WREC-UofA/WRECtangle/Designs/KiCAD Files/readme.md

This is where we'll put KiCAD projects / updates.
