WREC-UofA/WRECtangle/Designs/KiCAD Files/WRECtangleVersions/V4/Wrectangle-V4/WRECtangleMount.It1.SLDPRT

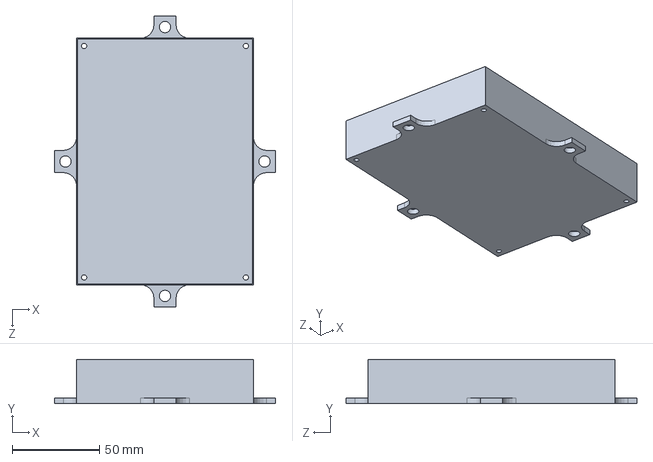
[picture p1: CAD file, 2026-02-07, an earlier design]
Designs/KiCAD Files/WRECtangleVersions/V4/Wrectangle-V4/WRECtangleMount.It1.SLDPRT
126.5 x 25.4 x 166.4 mm
