WREC-UofA/WRECtangle/Designs/KiCAD Files/WRECtangleVersions/V4/24V-RegulatorCircuit.pdf

## WEBENCH ® Design Report

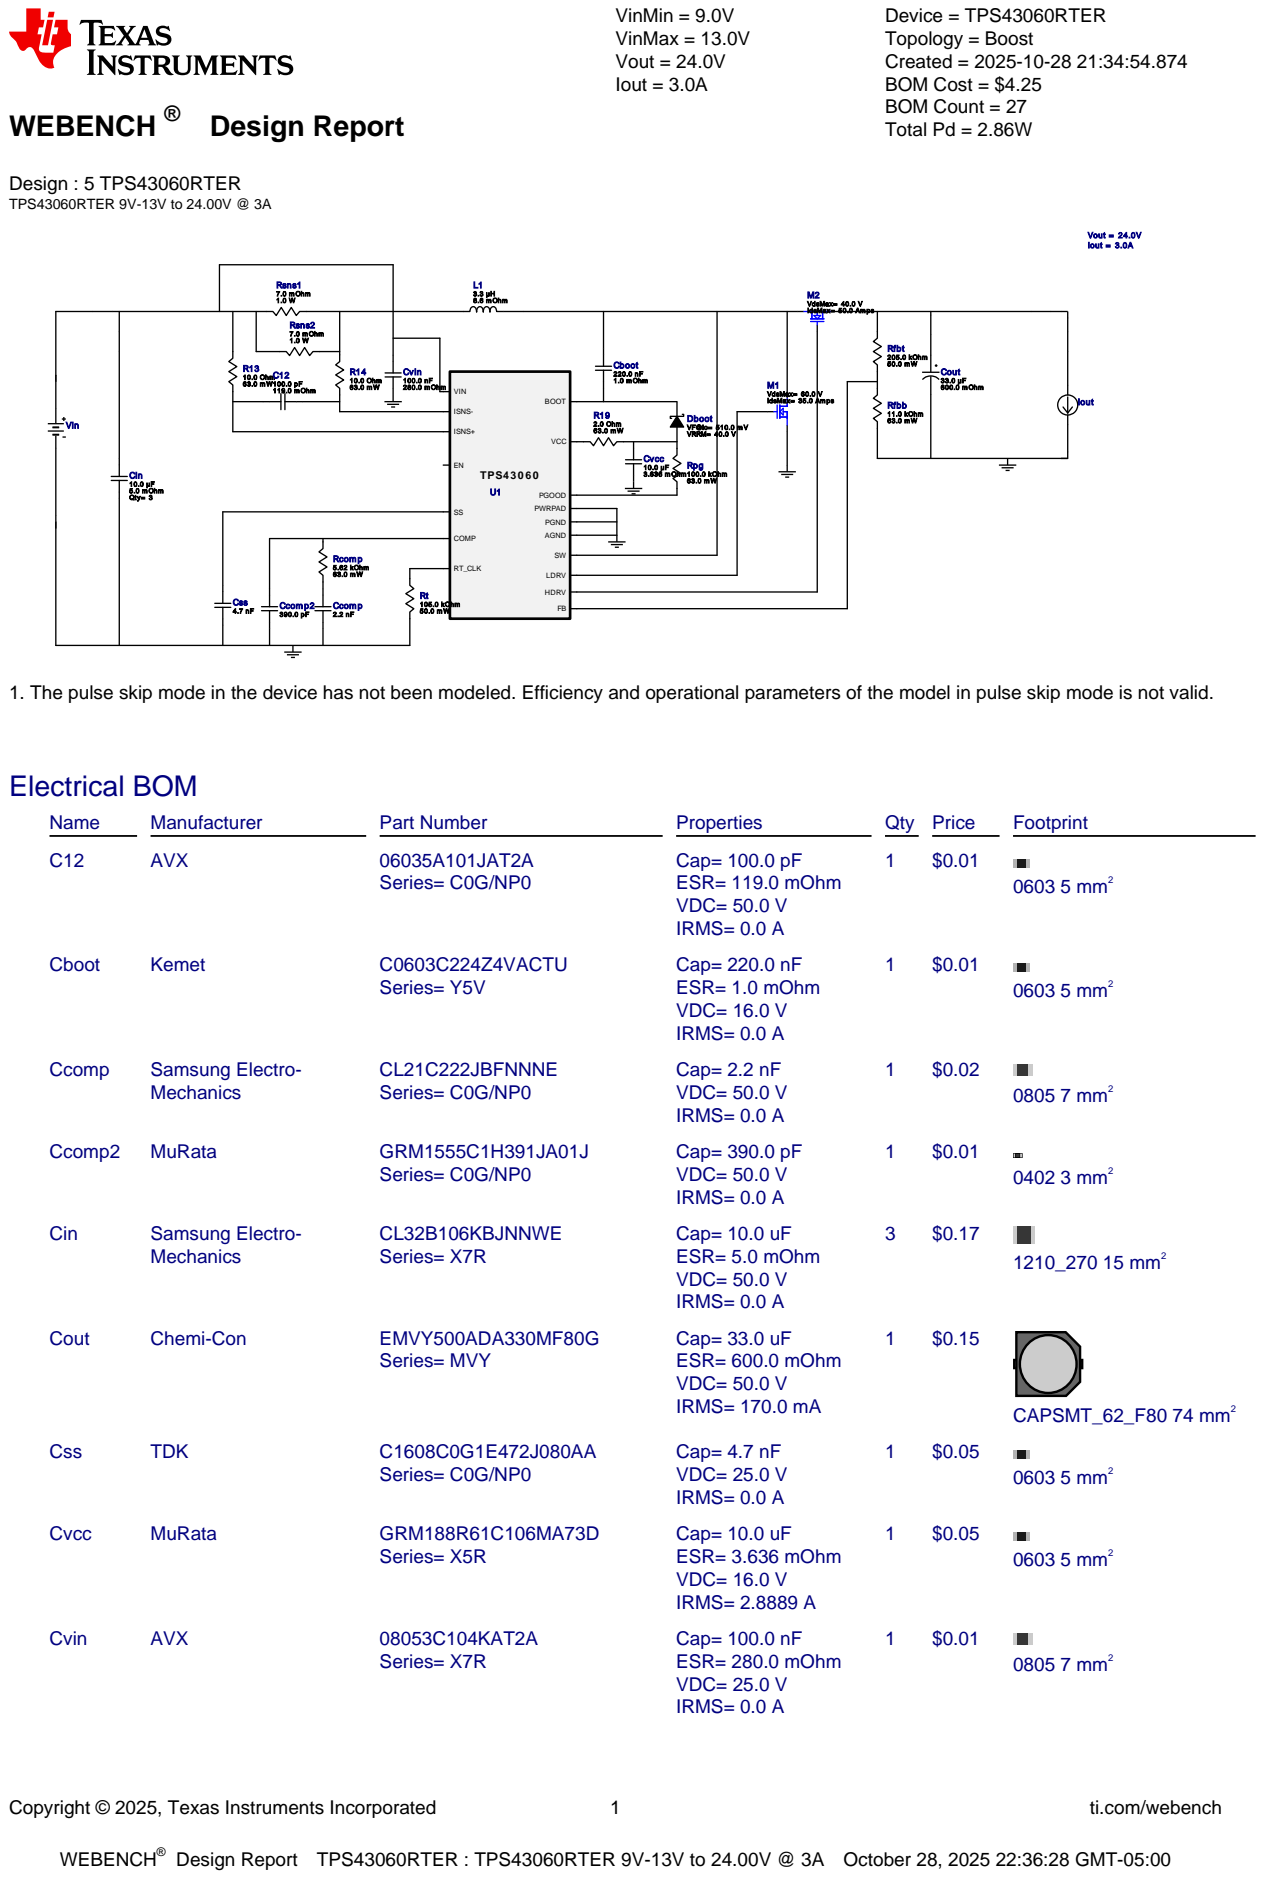
[picture p2: page 1]
Copyright © 2025, Texas Instruments Incorporated; ti.com/webench; WEBENCH®; Design : 5 TPS43060RTER TPS43060RTER 9V-13V to 24.00V @ 3A; VinMin = 9.0V VinMax = 13.0V Vout = 24.0V Iout = 3.0A; Device = TPS43060RTER Topology = Boost Created = 2025-10-28 21:34:54.874 BOM Cost = $4.25 BOM Count = 27 Total Pd = 2.86W; Cout 33.0 µF; 600.0 m Ohm; Cboot 220.0 nF; 1.0 m Ohm; VdsMax= 60.0; IdsMax= 35.0 Am ps; Rfbb; 11.0 kOhm 63.0 m W; R13 10.0 Ohm 63.0 m W; Rpg 100.0 kOhm 63.0 m W; Rfbt 205.0 kOhm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

1. The pulse skip mode in the device has not been modeled. Efficiency and operational parameters of the model in pulse skip mode is not valid.

Design Report TPS43060RTER : TPS43060RTER 9V-13V to 24.00V @ 3A October 28, 2025 22:36:28 GMT-05:00

Design

Copyright © 2025, Texas Instruments Incorporated | 2 | ti.com/webench
Name | Manufacturer | Part Number | Properties | Qty Price | Footprint
Dboot | Comchip Technology | CDBK0540-HF (http://www.comchiptech.com/cms/UserFiles/CDBK0540%2DHF%2DRevB797997.pdf) | VF@Io= 510.0 mV VRRM= 40.0 V
1 | $0.07
| | | | | SOD-123F 12 mm²
L1 | Coilcraft | XAL7070-332MEB (http://www.coilcraft.com/pdfs/xal7070.pdf) | L= 3.3 µH 8.6 mOhm
1 | $1.19

XAL7070 87 mm²
M1 | Texas Instruments | CSD18543Q3A (http://www.ti.com/lit/ds/symlink/csd18543q3a.pdf) | VdsMax= 60.0 V IdsMax= 35.0 Amps | 1 | $0.21

DNH0008A 18 mm²
M2 | Texas Instruments | CSD18514Q5A (http://www.ti.com/lit/ds/symlink/csd18514q5a.pdf) | VdsMax= 40.0 V IdsMax= 50.0 Amps | 1 | $0.22

TRANS_NexFET_Q5A 55
mm²
R13 | Vishay-Dale | CRCW040210R0FKED (http://www.vishay.com/docs/20035/dcrcwe3.pdf) Series= CRCW..e3 | Res= 10.0 Ohm Power= 63.0 mW Tolerance= 1.0% | 1 | $0.01
0402 3 mm²
R14 | Vishay-Dale | CRCW040210R0FKED (http://www.vishay.com/docs/20035/dcrcwe3.pdf) Series= CRCW..e3 | Res= 10.0 Ohm Power= 63.0 mW Tolerance= 1.0% | 1 | $0.01
0402 3 mm²
R19 | Vishay-Dale | CRCW04022R00FKED (http://www.vishay.com/docs/20035/dcrcwe3.pdf) Series= CRCW..e3 | Res= 2.0 Ohm Power= 63.0 mW Tolerance= 1.0% | 1 | $0.01
0402 3 mm²
Rcomp | Vishay-Dale | CRCW04025K62FKED (http://www.vishay.com/docs/20035/dcrcwe3.pdf) Series= CRCW..e3 | Res= 5.62 kOhm Power= 63.0 mW Tolerance= 1.0% | 1 | $0.01
0402 3 mm²
Rfbb | Vishay-Dale | CRCW040211K0FKED (http://www.vishay.com/docs/20035/dcrcwe3.pdf) Series= CRCW..e3 | Res= 11.0 kOhm Power= 63.0 mW Tolerance= 1.0% | 1 | $0.01
0402 3 mm²
Rfbt | Yageo | RC0201FR-07205KL (http://www.yageo.com/exep/pages/download/literatures/PYu%2DR%5FMarking%5F2.pdf) Series= ? | Res= 205.0 kOhm Power= 50.0 mW Tolerance= 1.0% | 1 | $0.01
0201 2 mm²
Rpg | Vishay-Dale | CRCW0402100KFKED (http://www.vishay.com/docs/20035/dcrcwe3.pdf) Series= CRCW..e3 | Res= 100.0 kOhm Power= 63.0 mW Tolerance= 1.0% | 1 | $0.01
0402 3 mm²
Rsns1 | Susumu Co Ltd | PRL1632-R007-F-T1 (http://www.susumu%2Dusa.com/pdf/PRL%5FRL%5FData%5Fsheet.pdf) Series= PRL1632 | Res= 7.0 mOhm Power= 1.0 W Tolerance= 1.0% | 1 | $0.20

0612 11 mm²

Rsns2 | Susumu Co Ltd | PRL1632-R007-F-T1 (http://www.susumu%2Dusa.com/pdf/PRL%5FRL%5FData%5Fsheet.pdf) Series= PRL1632 | Res= 7.0 mOhm Power= 1.0 W Tolerance= 1.0% | 1 | $0.20

0612 11 mm²

Rt | Yageo | RC0201FR-07105KL (http://www.yageo.com/exep/pages/download/literatures/PYu%2DR%5FMarking%5F2.pdf) Series= ? | Res= 105.0 kOhm Power= 50.0 mW Tolerance= 1.0% | 1 | $0.01
0201 2 mm²
U1 | Texas Instruments | TPS43060RTER (http://www.ti.com/product/TPS43060) | Switcher | 1 | $1.09

S-PVQFN-N16 17 mm²

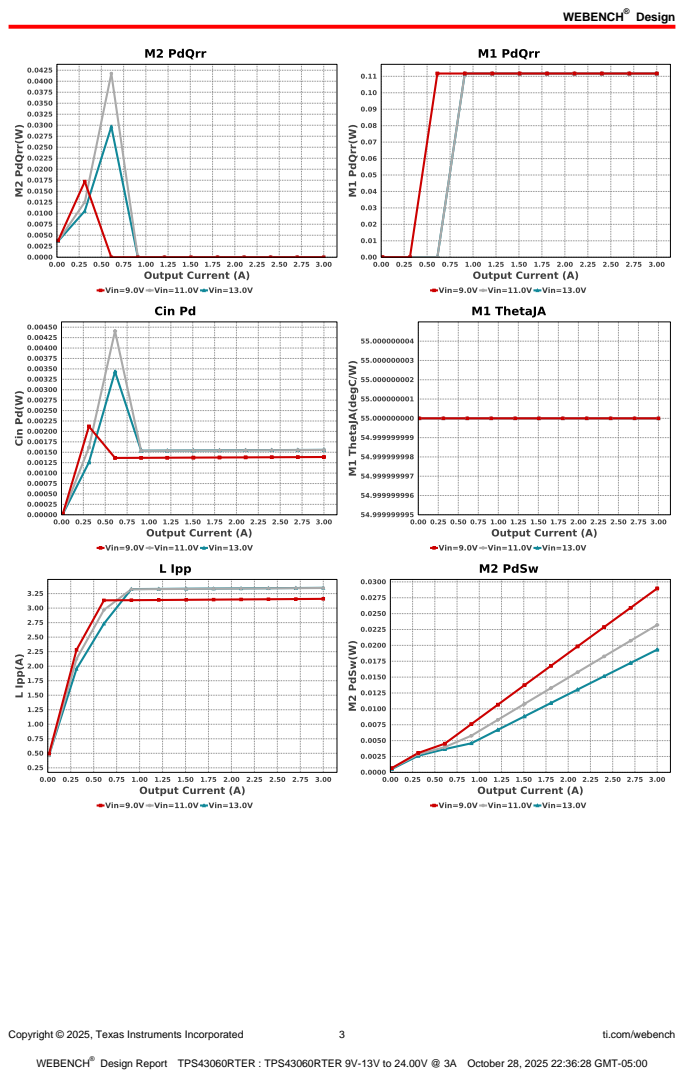
[picture p3: page 3]
Copyright © 2025, Texas Instruments Incorporated; ti.com/webench

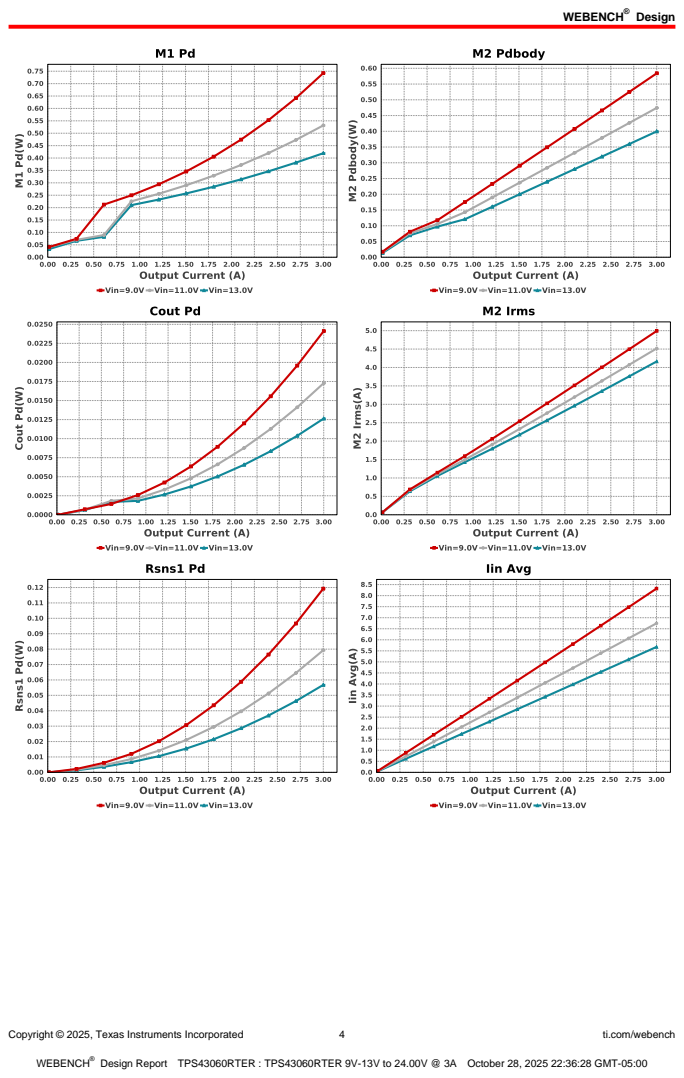
[picture p4: page 4]
Copyright © 2025, Texas Instruments Incorporated; ti.com/webench

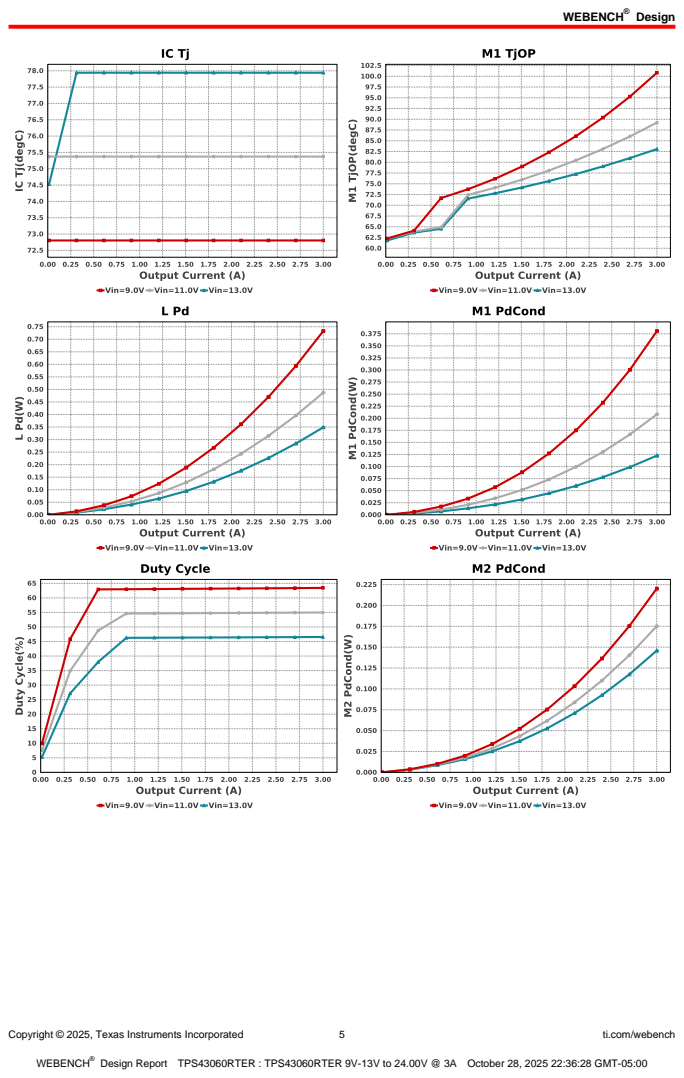
[picture p5: page 5]
Copyright © 2025, Texas Instruments Incorporated; ti.com/webench

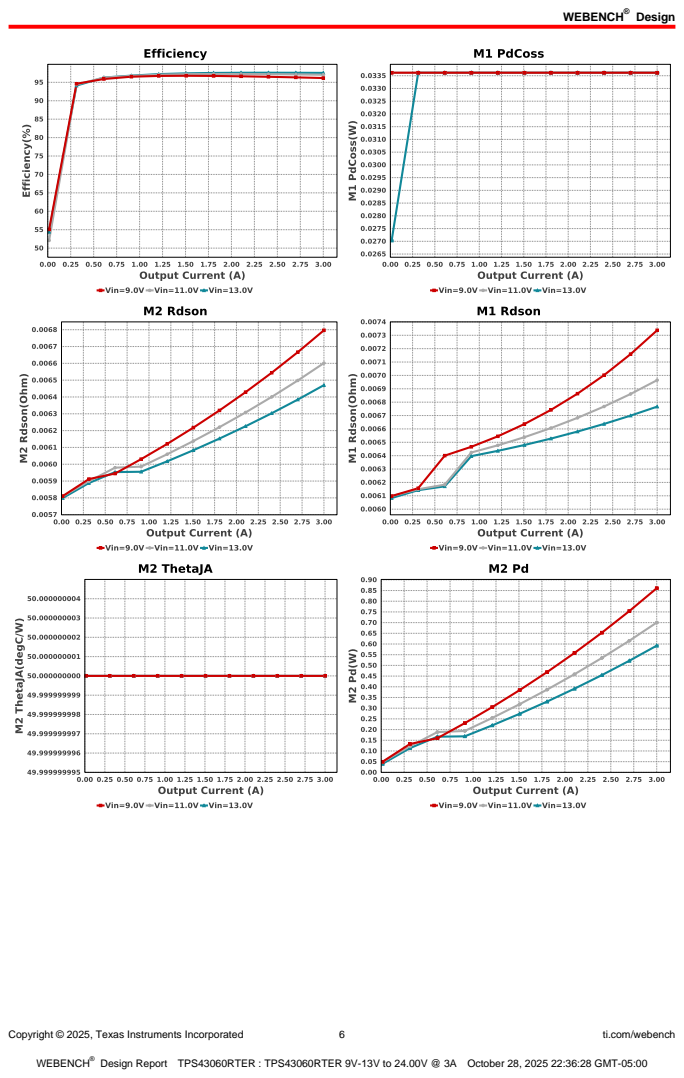
[picture p6: page 6]
Copyright © 2025, Texas Instruments Incorporated; ti.com/webench

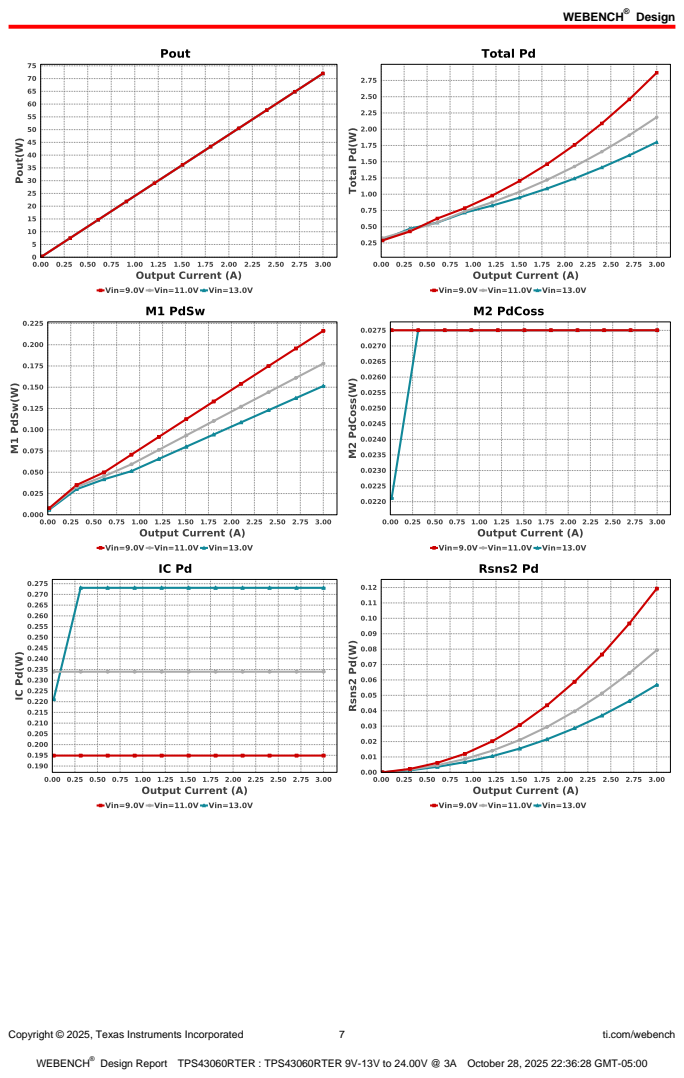
[picture p7: page 7]
Copyright © 2025, Texas Instruments Incorporated; ti.com/webench

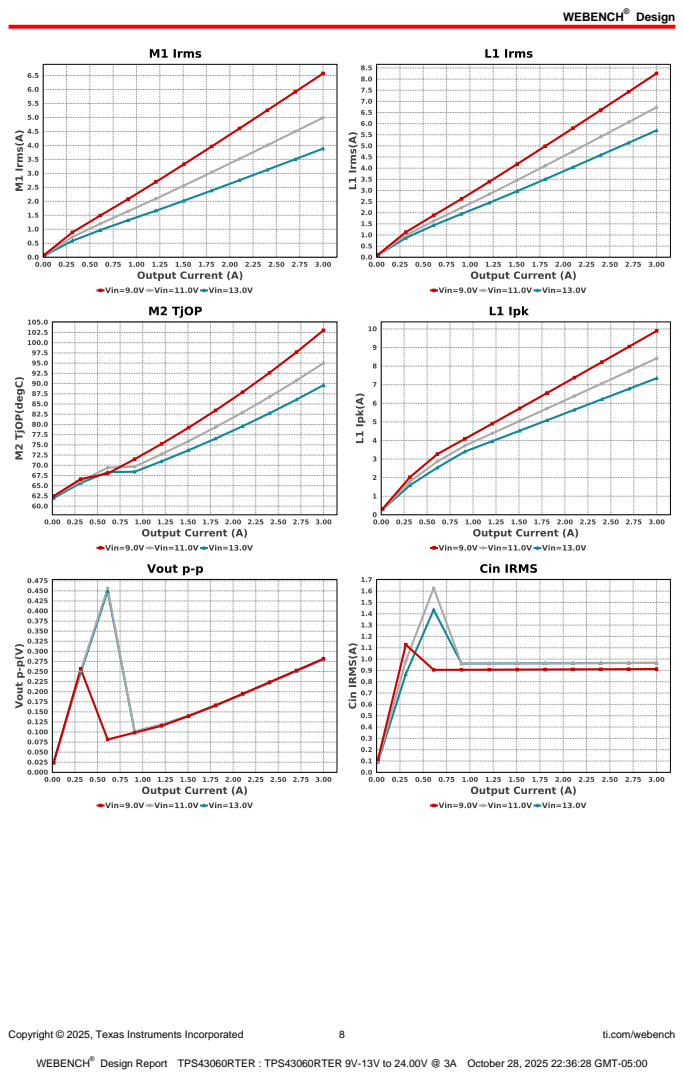
[picture p8: page 8]
Copyright © 2025, Texas Instruments Incorporated; ti.com/webench

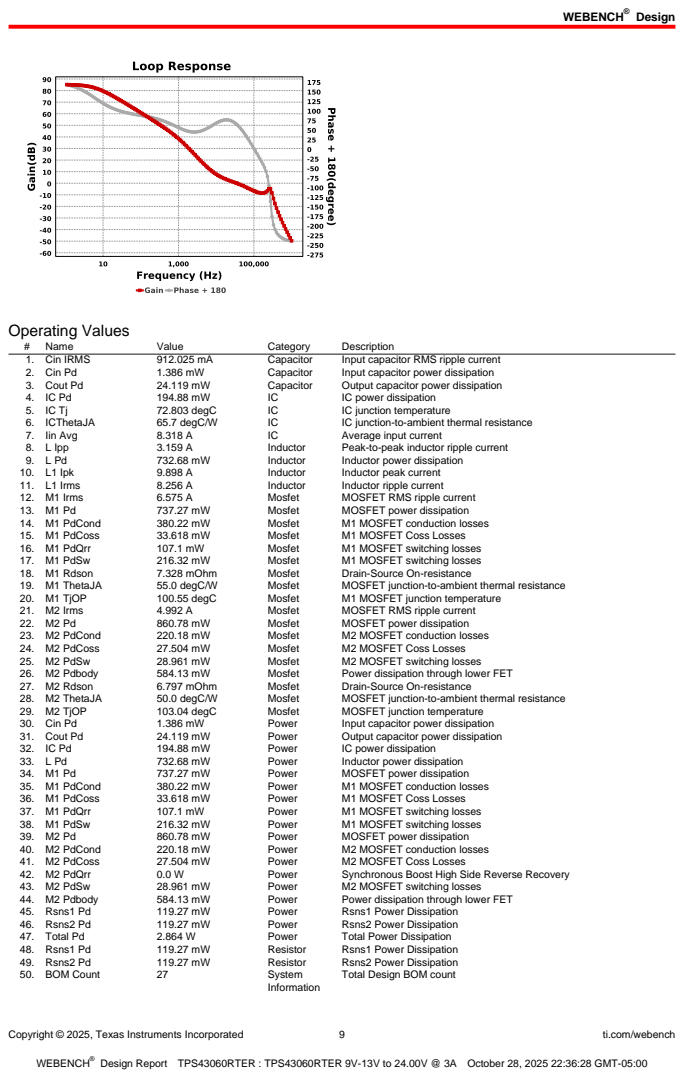
[picture p9: page 9]
Copyright © 2025, Texas Instruments Incorporated; ti.com/webench; Operating Values; Name; Value; Category; Description; 1. Cin IRMS; Capacitor; Input capacitor RMS ripple current; 2. Cin Pd; Input capacitor power dissipation; 3. Cout Pd; Output capacitor power dissipation; IC power dissipation; 72.803 degC; IC junction temperature; 6. ICThetaJA; 65.7 degC/W; IC junction-to-ambient thermal resistance; 7. Iin Avg; Average input current; 8. L Ipp; Inductor; Peak-to-peak inductor ripple current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

Total Design BOM count

Copyright © 2025, Texas Instruments Incorporated | 10 | ti.com/webench
# | Name | Value | Category | Description

51. Cross Freq | 20.656 kHz | System
| | | Information | Bode plot crossover frequency
52. Duty Cycle | 63.438 % | System
| | | Information | Duty cycle
53. Efficiency | 96.174 % | System
| | | Information | Steady state efficiency
54. FootPrint | 402.0 mm² | System
| | | Information | Total Foot Print Area of BOM components
55. Frequency | 547.619 kHz | System
| | | Information | Switching frequency
56. Gain Marg | -5.148 dB | System
| | | Information | Bode Plot Gain Margin
57. Iout | 3.0 A | System
| | | Information | Iout operating point
58. Low Freq Gain | 83.372 dB | System
| | | Information | Gain at 1Hz
59. Mode | CCM | System
| | | Information | Conduction Mode
60. Phase Marg | 66.713 deg | System
| | | Information | Bode Plot Phase Margin
61. Pout | 72.0 W | System
| | | Information | Total output power
62. Total BOM | $4.25 | System
| | | Information | Total BOM Cost
63. Vin | 9.0 V | System
| | | Information | Vin operating point
64. Vout | 24.0 V | System
| | | Information | Operational Output Voltage
65. Vout Actual | 23.956 V | System
| | | Information | Vout Actual calculated based on selected voltage divider resistors
66. Vout Tolerance | 4.006 % | System
| | | Information | Vout Tolerance based on IC Tolerance (no load) and voltage divider resistors if applicable
67. Vout p-p | 281.771 mV | System
| | | Information | Peak-to-peak output ripple voltage

## Design Inputs

Name | Value | Description
Iout | 3.0 | Maximum Output Current
VinMax | 13.0 | Maximum input voltage
VinMin | 9.0 | Minimum input voltage
Vout | 24.0 | Output Voltage
| base_pn | | TPS43060 | Base Product Number
source | DC | Input Source Type
Ta | 60.0 | Ambient temperature


Copyright © 2025, Texas Instruments Incorporated | 11 | ti.com/webench

## Assembly

## Component Testing

Some published data on components in datasheets such as Capacitor ESR and Inductor DC resistance is based on conservative values that will guarantee that the components always exceed the specification. For design purposes it is usually better to work with typical values. Since this data is not always available it is a good practice to measure the Capacitance and ESR values of Cin and Cout, and the inductance and DC resistance of L1 before assembly of the board. Any large discrepancies in values should be electrically simulated in WEBENCH to check for instabilities and thermally simulated in WebTHERM to make sure critical temperatures are not exceeded.

## Soldering Component to Board

If board assembly is done in house it is best to tack down one terminal of a component on the board then solder the other terminal. For surface mount parts with large tabs, such as the DPAK, the tab on the back of the package should be pre-tinned with solder, then tacked into place by one of the pins. To solder the tab town to the board place the iron down on the board while resting against the tab, heating both surfaces simultaneously. Apply light pressure to the top of the plastic case until the solder flows around the part and the part is flush with the PCB. If the solder is not flowing around the board you may need a higher wattage iron (generally 25W to 30W is enough).

## Initial Startup of Circuit

It is best to initially power up the board by setting the input supply voltage to the lowest operating input voltage 9.0V and set the input supply's current limit to zero. With the input supply off connect up the input supply to Vin and GND. Connect a digital volt meter and a load if needed to set the minimum Iout of the design from Vout and GND. Turn on the input supply and slowly turn up the current limit on the input supply. If the voltage starts to rise on the input supply continue increasing the input supply current limit while watching the output voltage. If the current increases on the input supply, but the voltage remains near zero, then there may be a short or a component misplaced on the board. Power down the board and visually inspect for solder bridges and recheck the diode and capacitor polarities. Once the power supply circuit is operational then more extensive testing may include full load testing, transient load and line tests to compare with simulation results.

## Load Testing

The setup is the same as the initial startup, except that an additional digital voltmeter is connected between Vin and GND, a load is connected between Vout and GND and a current meter is connected in series between Vout and the load. The load must be able to handle at least rated output power + 50% ( 7.5 watts for this design). Ideally the load is supplied in the form of a variable load test unit. It can also be done in the form of suitably large power resistors. When using an oscilloscope to measure waveforms on the prototype board, the ground leads of the oscilloscope probes should be as short as possible and the area of the loop formed by the ground lead should be kept to a minimum. This will help reduce ground lead inductance and eliminate EMI noise that is not actually present in the circuit.

## Design Assistance

1. Feature Highlights: Low Quiescent Current Boost Controller, Wide Vin Range 4.5V to 38V Vin, 58V Vout, 7.5V Gate Drive optimized for standard MOSFET Thresholds Thermal Shutdown
2. Master key : AD9ABD3FB6EB8E71BDFD117B90420B13[v1]
3. TPS43060 Product Folder : http://www.ti.com/product/TPS43060 : contains the data sheet and other resources.

Copyright © 2025, Texas Instruments Incorporated | 12 | ti.com/webench

Important Notice and Disclaimer

TI provides technical and reliability data (including datasheets), design resources (including reference designs), application or other design advice, web tools, safety information, and other resources AS IS and with all faults, and disclaims all warranties. These resources are intended for skilled developers designing with TI products. You are solely responsible for (1) selecting the appropriate TI products for your application, (2) designing, validating and testing your application, and (3) ensuring your application meets applicable standards, and any other safety, security, or other requirements.

These resources are subject to change without notice. TI grants you permission to use these resources only for development of an application that uses the TI products described in the resource. Other reproduction and display of these resources is prohibited. No license is granted to any other TI intellectual property right or to any third party intellectual property right. TI disclaims responsibility for, and you will fully indemnify TI and its representatives against, any claims, damages, costs, losses, and liabilities arising out of your use of these resources.

Providing these resources does not expand or otherwise alter TI's applicable Terms of Sale or other applicable terms available either on ti.com or provided in conjunction with TI products.
