WREC-UofA/WRECtangle/Designs/KiCAD Files/WRECtangleVersions/V4/3.3V-Circuit.pdf

## WEBENCH ® Design Report

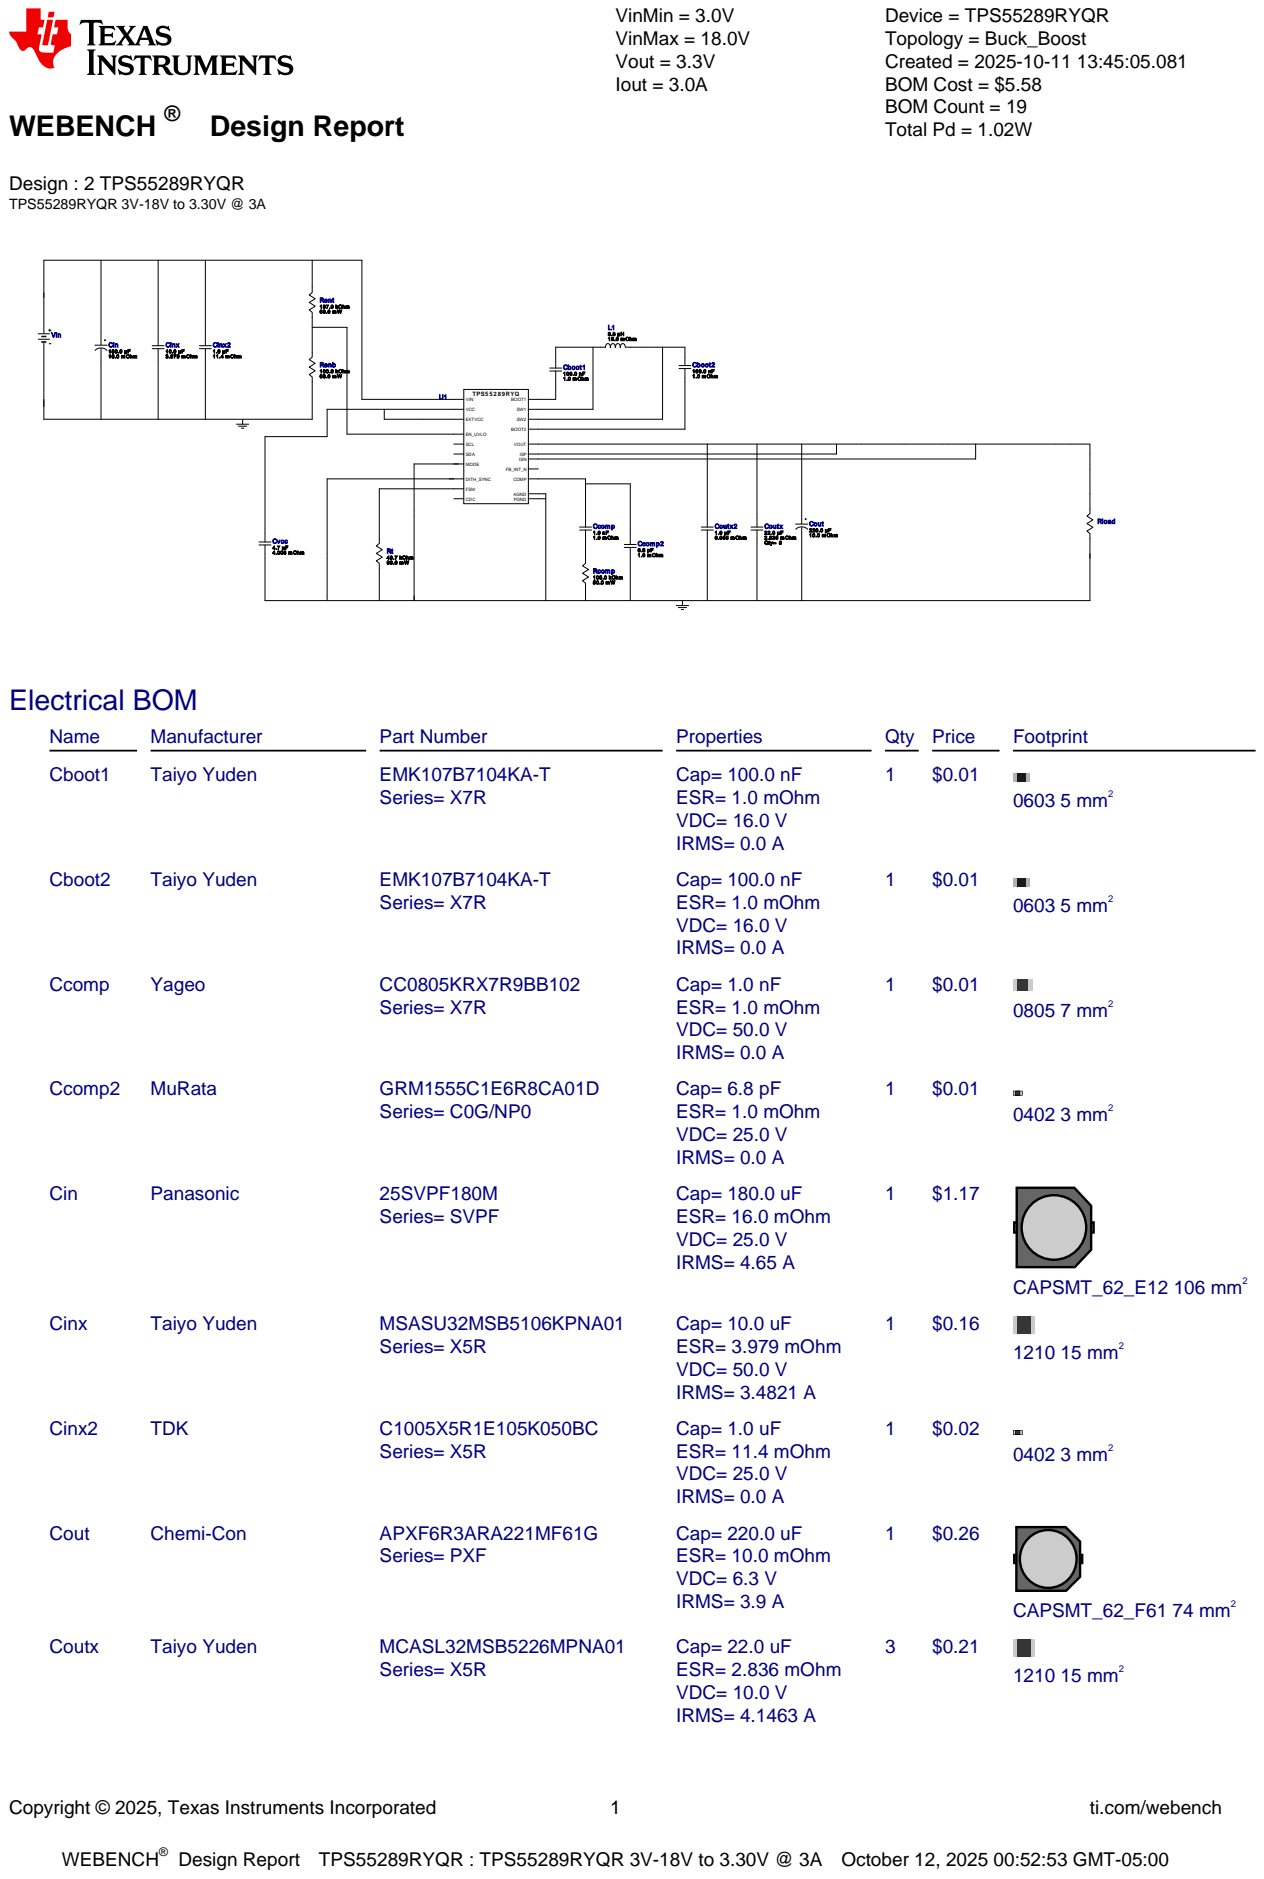
[picture p11: page 1]
Copyright © 2025, Texas Instruments Incorporated; ti.com/webench; WEBENCH®; Design : 2 TPS55289RYQR TPS55289RYQR 3V-18V to 3.30V @ 3A; VinMin = 3.0V VinMax = 18.0V Vout = 3.3V Iout = 3.0A; Device = TPS55289RYQR Topology = Buck_Boost Created = 2025-10-11 13:45:05.081 BOM Cost = $5.58 BOM Count = 19 Total Pd = 1.02W; Ccom p2 6.8 pF 1.0 m Ohm Rcom p; 105.0 kOhm 50.0 m W; Coutx2 1.0 µF 6.065 m Ohm; L1 3.8 µH 13.0 m Ohm Cinx; 3.979 m Ohm Cin 180.0 µF 16.0 m Ohm; Ccom p 1.0 nF 1.0 m Ohm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

Qty= 3 Rt 48.7 kOhm

Design Report TPS55289RYQR : TPS55289RYQR 3V-18V to 3.30V @ 3A October 12, 2025 00:52:53 GMT-05:00

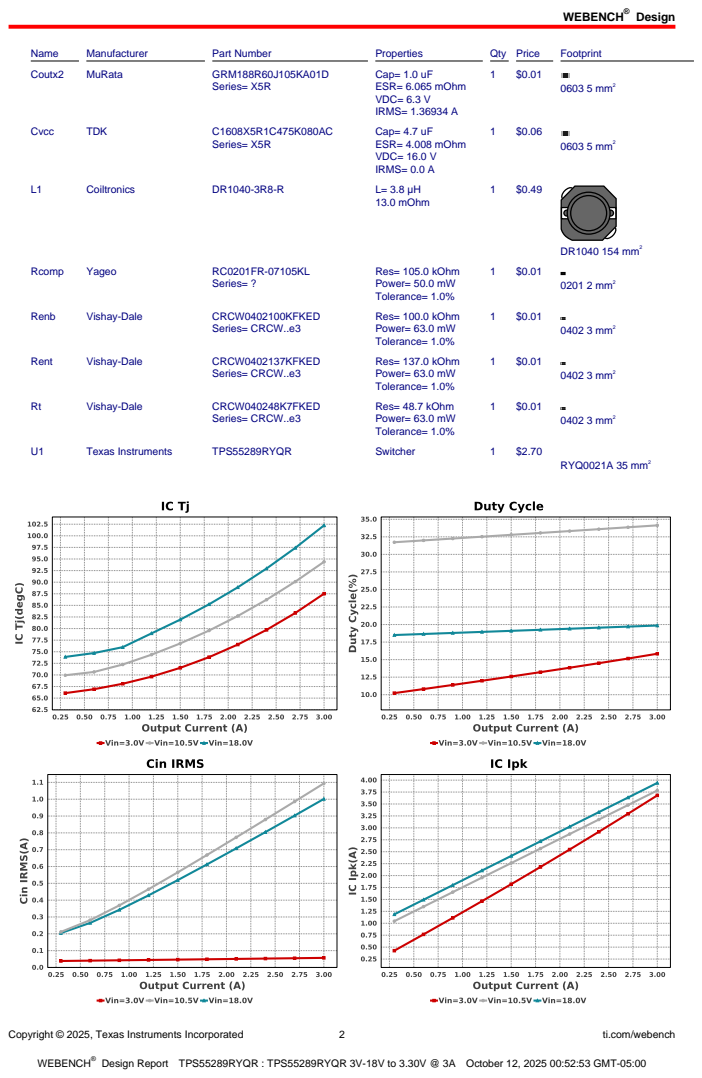
[picture p12: page 2]
Design; Copyright © 2025, Texas Instruments Incorporated; ti.com/webench; Name; Manufacturer; Part Number; Properties; Qty Price; Footprint; Coutx2; MuRata; GRM188R60J105KA01D; Series= X5R; Cap= 1.0 uF ESR= 6.065 mOhm VDC= 6.3 V IRMS= 1.36934 A; 0603 5 mm²; Cvcc; TDK; Cap= 4.7 uF ESR= 4.008 mOhm VDC= 16.0 V IRMS= 0.0 A; Coiltronics; 13.0 mOhm; DR1040 154 mm²; Rcomp; Yageo; Series= ?; Res= 105.0 kOhm Power= 50.0 mW Tolerance= 1.0%; 0201 2 mm²; Renb; Vishay-Dale; CRCW0402100KFKED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

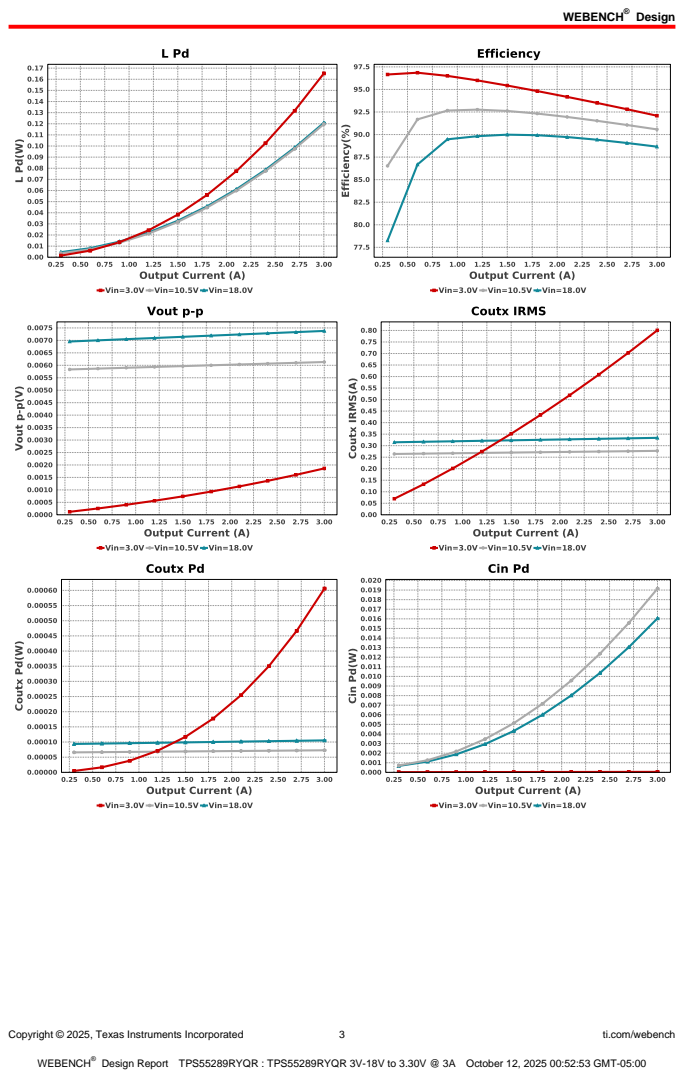
[picture p13: page 3]
Copyright © 2025, Texas Instruments Incorporated; ti.com/webench

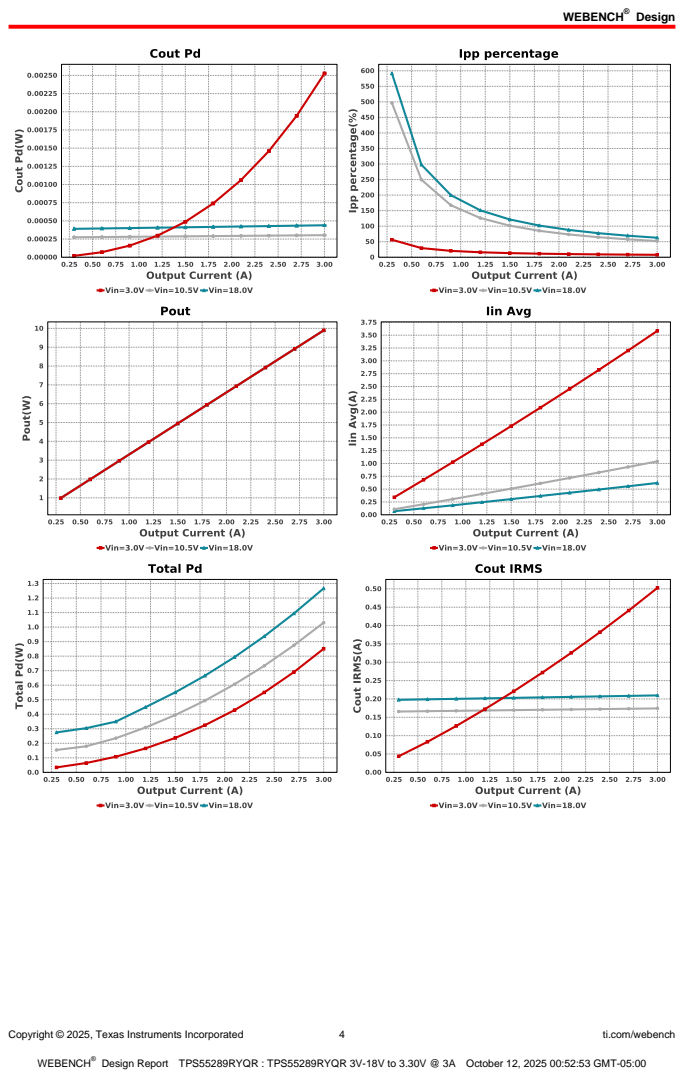
[picture p14: page 4]
Copyright © 2025, Texas Instruments Incorporated; ti.com/webench

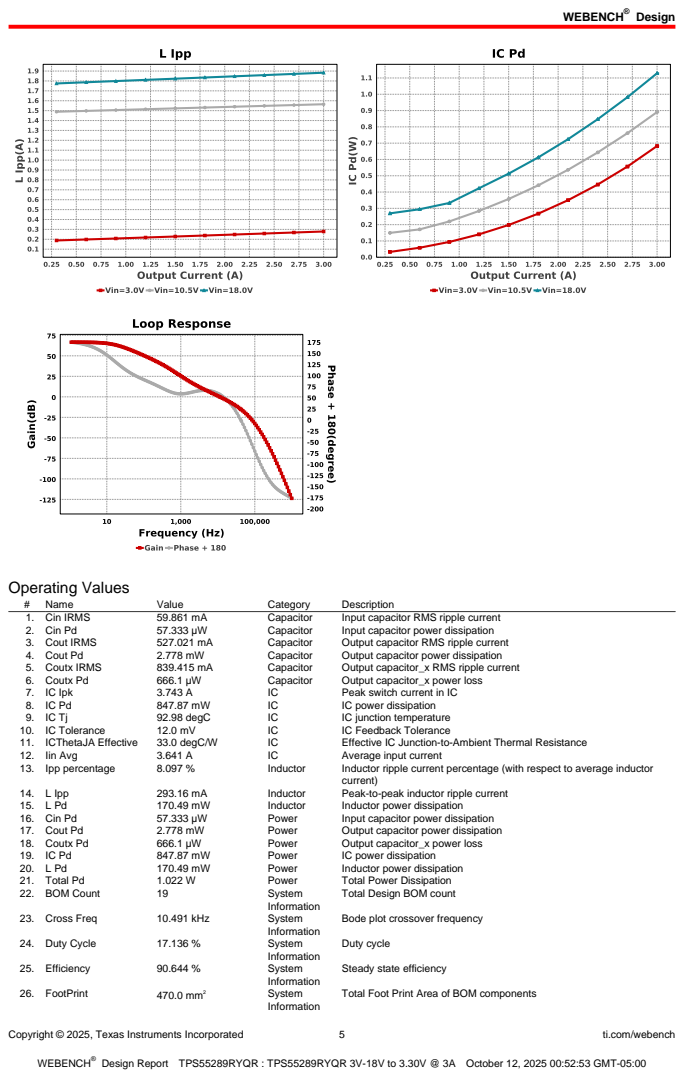
[picture p15: page 5]
Copyright © 2025, Texas Instruments Incorporated; ti.com/webench; Operating Values; Name; Value; Category; Description; 1. Cin IRMS; Capacitor; Input capacitor RMS ripple current; 2. Cin Pd; Input capacitor power dissipation; 3. Cout IRMS; Output capacitor RMS ripple current; 4. Cout Pd; Output capacitor power dissipation; 5. Coutx IRMS; Output capacitor_x RMS ripple current; 6. Coutx Pd; Output capacitor_x power loss; 7. IC Ipk; Peak switch current in IC; IC power dissipation; 92.98 degC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

Total Design BOM count

Bode plot crossover frequency

Steady state efficiency

Total Foot Print Area of BOM components

Copyright © 2025, Texas Instruments Incorporated | 6 | ti.com/webench
# | Name | Value | Category | Description

27. Frequency | 402.82 kHz | System
| | | Information | Switching frequency
28. Gain Marg | -13.015 dB | System
| | | Information | Bode Plot Gain Margin
29. Iout | 3.0 A | System
| | | Information | Iout operating point
30. Low Freq Gain | 59.769 dB | System
| | | Information | Gain at 1Hz
31. Mode | CCM | System
| | | Information | Conduction Mode
32. Phase Marg | 58.238 deg | System
| | | Information | Bode Plot Phase Margin
33. Pout | 9.9 W | System
| | | Information | Total output power
34. Total BOM | $5.58 | System
| | | Information | Total BOM Cost
35. Vin | 3.0 V | System
| | | Information | Vin operating point
36. Vout | 3.3 V | System
| | | Information | Operational Output Voltage
37. Vout Tolerance | 363.64 m% | System
| | | Information | Vout Tolerance based on IC Tolerance (no load) and voltage divider resistors if applicable
38. Vout p-p | 2.015 mV | System
| | | Information | Peak-to-peak output ripple voltage
39. Vref | 1.978 kh; | System
| | | Information | Register VREF

## Design Inputs

Name | Value | Description
Iout | 3.0 | Maximum Output Current
VinMax | 18.0 | Maximum input voltage
VinMin | 3.0 | Minimum input voltage
Vout | 3.3 | Output Voltage
| base_pn | | TPS55289 | Base Product Number
source | DC | Input Source Type
Ta | 65.0 | Ambient temperature


Copyright © 2025, Texas Instruments Incorporated | 7 | ti.com/webench

## Assembly

## Component Testing

Some published data on components in datasheets such as Capacitor ESR and Inductor DC resistance is based on conservative values that will guarantee that the components always exceed the specification. For design purposes it is usually better to work with typical values. Since this data is not always available it is a good practice to measure the Capacitance and ESR values of Cin and Cout, and the inductance and DC resistance of L1 before assembly of the board. Any large discrepancies in values should be electrically simulated in WEBENCH to check for instabilities and thermally simulated in WebTHERM to make sure critical temperatures are not exceeded.

## Soldering Component to Board

If board assembly is done in house it is best to tack down one terminal of a component on the board then solder the other terminal. For surface mount parts with large tabs, such as the DPAK, the tab on the back of the package should be pre-tinned with solder, then tacked into place by one of the pins. To solder the tab town to the board place the iron down on the board while resting against the tab, heating both surfaces simultaneously. Apply light pressure to the top of the plastic case until the solder flows around the part and the part is flush with the PCB. If the solder is not flowing around the board you may need a higher wattage iron (generally 25W to 30W is enough).

## Initial Startup of Circuit

It is best to initially power up the board by setting the input supply voltage to the lowest operating input voltage 3.0V and set the input supply's current limit to zero. With the input supply off connect up the input supply to Vin and GND. Connect a digital volt meter and a load if needed to set the minimum Iout of the design from Vout and GND. Turn on the input supply and slowly turn up the current limit on the input supply. If the voltage starts to rise on the input supply continue increasing the input supply current limit while watching the output voltage. If the current increases on the input supply, but the voltage remains near zero, then there may be a short or a component misplaced on the board. Power down the board and visually inspect for solder bridges and recheck the diode and capacitor polarities. Once the power supply circuit is operational then more extensive testing may include full load testing, transient load and line tests to compare with simulation results.

## Load Testing

The setup is the same as the initial startup, except that an additional digital voltmeter is connected between Vin and GND, a load is connected between Vout and GND and a current meter is connected in series between Vout and the load. The load must be able to handle at least rated output power + 50% ( 7.5 watts for this design). Ideally the load is supplied in the form of a variable load test unit. It can also be done in the form of suitably large power resistors. When using an oscilloscope to measure waveforms on the prototype board, the ground leads of the oscilloscope probes should be as short as possible and the area of the loop formed by the ground lead should be kept to a minimum. This will help reduce ground lead inductance and eliminate EMI noise that is not actually present in the circuit.

## Design Assistance

1. Master key : AD9ABD3FB6EB8E71BDFD117B90420B13[v1]
2. TPS55289 Product Folder : https://www.ti.com/product/TPS55289 : contains the data sheet and other resources.

Copyright © 2025, Texas Instruments Incorporated | 8 | ti.com/webench

Important Notice and Disclaimer

TI provides technical and reliability data (including datasheets), design resources (including reference designs), application or other design advice, web tools, safety information, and other resources AS IS and with all faults, and disclaims all warranties. These resources are intended for skilled developers designing with TI products. You are solely responsible for (1) selecting the appropriate TI products for your application, (2) designing, validating and testing your application, and (3) ensuring your application meets applicable standards, and any other safety, security, or other requirements.

These resources are subject to change without notice. TI grants you permission to use these resources only for development of an application that uses the TI products described in the resource. Other reproduction and display of these resources is prohibited. No license is granted to any other TI intellectual property right or to any third party intellectual property right. TI disclaims responsibility for, and you will fully indemnify TI and its representatives against, any claims, damages, costs, losses, and liabilities arising out of your use of these resources.

Providing these resources does not expand or otherwise alter TI's applicable Terms of Sale or other applicable terms available either on ti.com or provided in conjunction with TI products.
