WREC-UofA/WRECtangle/Designs/KiCAD Files/WRECtangleVersions/V4/5V-RegulatorCircuit-updated.pdf

## WEBENCH ® Design Report

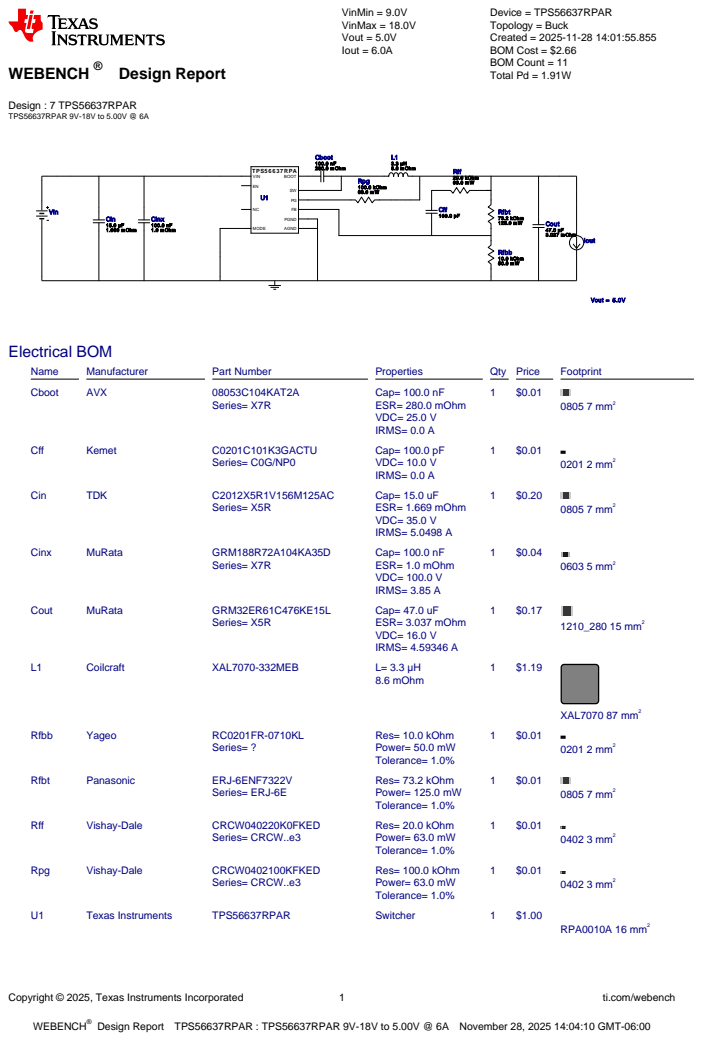
[picture p16: page 1]
Copyright © 2025, Texas Instruments Incorporated; ti.com/webench; WEBENCH®; Design : 7 TPS56637RPAR TPS56637RPAR 9V-18V to 5.00V @ 6A; VinMin = 9.0V VinMax = 18.0V Vout = 5.0V Iout = 6.0A; Device = TPS56637RPAR Topology = Buck Created = 2025-11-28 14:01:55.855 BOM Cost = $2.66 BOM Count = 11 Total Pd = 1.91W; Vout = 5.0V; Cinx 100.0 nF 1.0 m Ohm; TPS5 6 6 3 7 RPA; AGND; VIN; BOOT; PGND; MODE; Rpg 100.0 kOhm 63.0 m W; Cin 15.0 µF 1.669 m Ohm; Cff 100.0 pF; Rff 20.0 kOhm 63.0 m W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

Design Report TPS56637RPAR : TPS56637RPAR 9V-18V to 5.00V @ 6A November 28, 2025 14:04:10 GMT-06:00

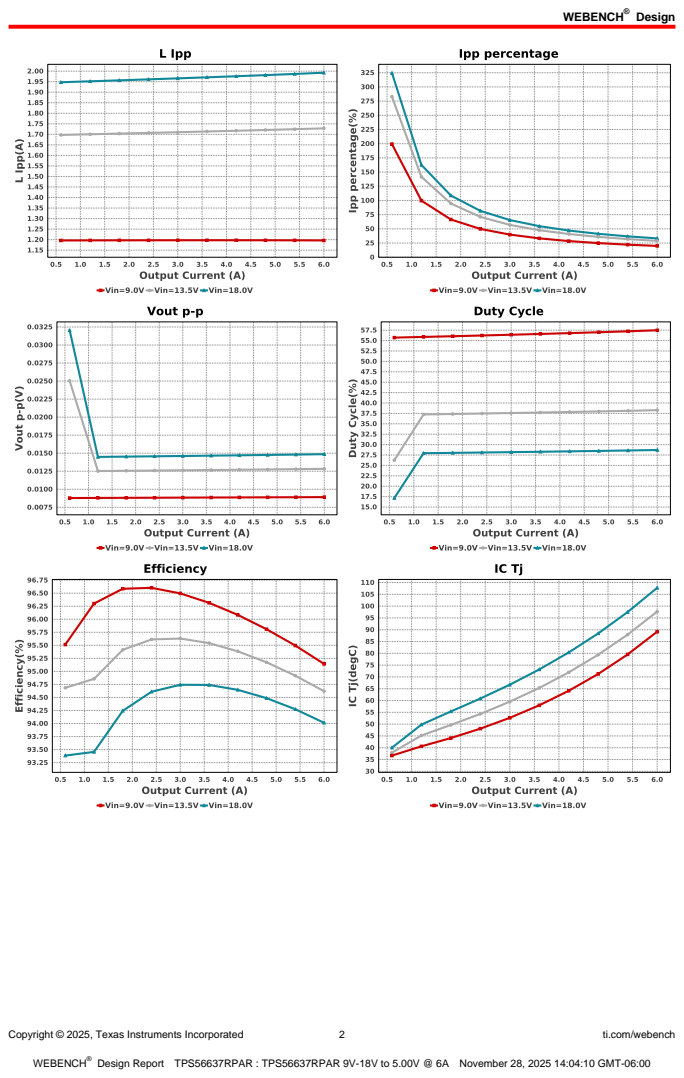
[picture p17: page 2]
Design; Copyright © 2025, Texas Instruments Incorporated; ti.com/webench

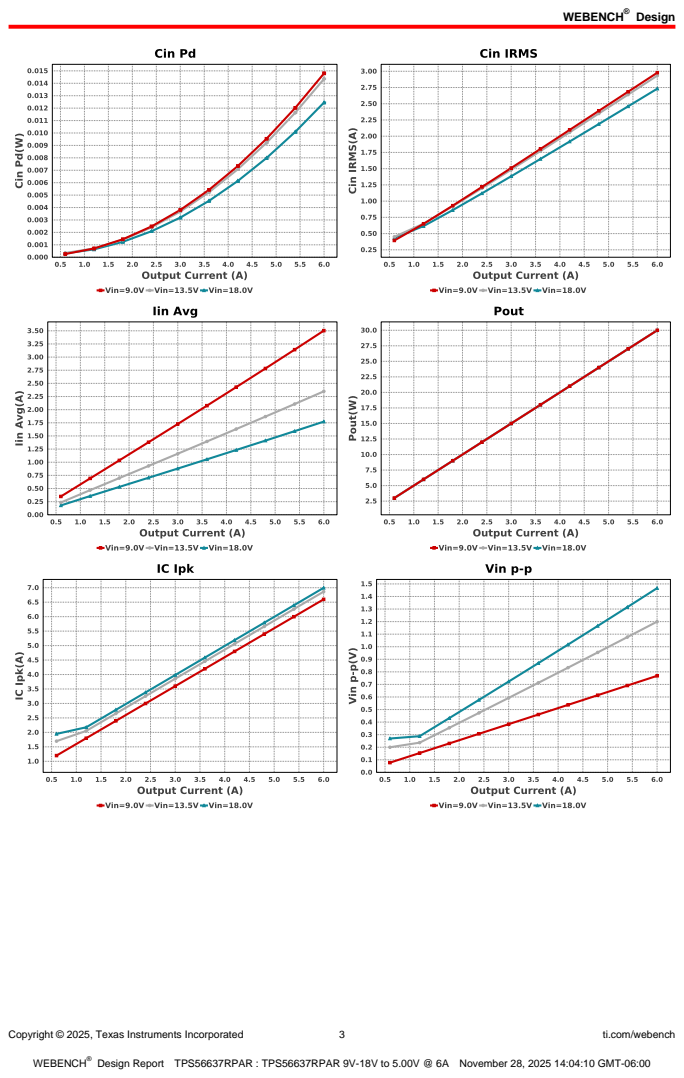
[picture p18: page 3]
Copyright © 2025, Texas Instruments Incorporated; ti.com/webench

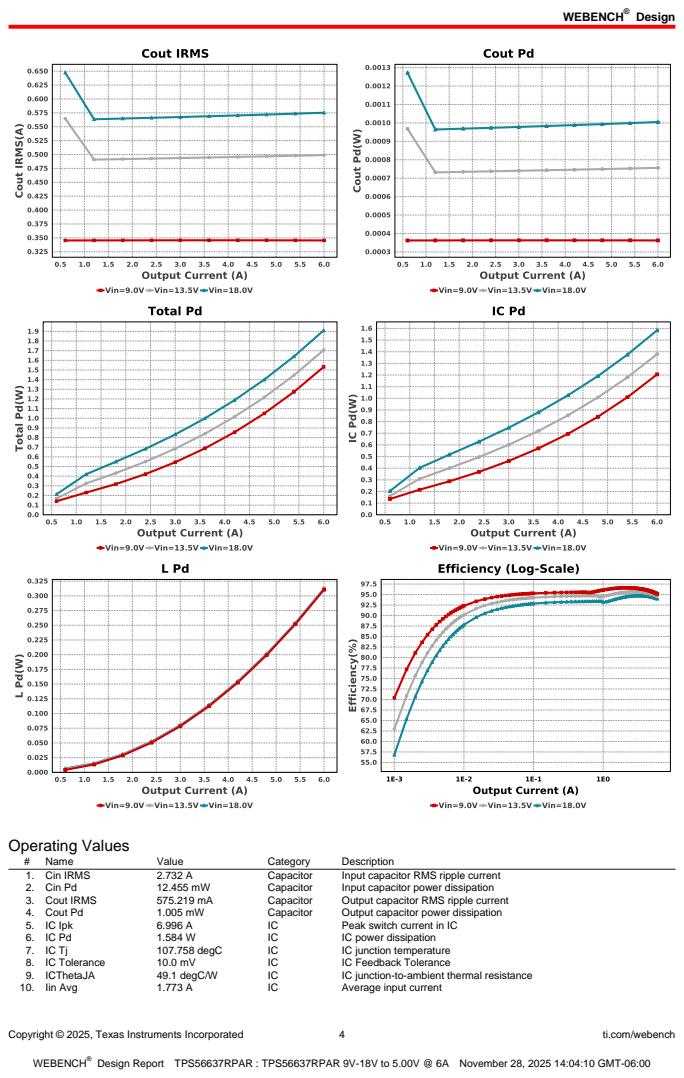
[picture p19: page 4]
Copyright © 2025, Texas Instruments Incorporated; ti.com/webench; Operating Values; Name; Value; Category; Description; 1. Cin IRMS; Capacitor; Input capacitor RMS ripple current; 2. Cin Pd; Input capacitor power dissipation; 3. Cout IRMS; Output capacitor RMS ripple current; 4. Cout Pd; Output capacitor power dissipation; 5. IC Ipk; Peak switch current in IC; IC power dissipation; 107.758 degC; IC junction temperature; 8. IC Tolerance; IC Feedback Tolerance; 9. ICThetaJA; 49.1 degC/W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

Copyright © 2025, Texas Instruments Incorporated | 5 | ti.com/webench
# | Name | Value | Category | Description

11. Ipp percentage | 33.21 % | Inductor | Inductor ripple current percentage (with respect to average inductor
| | | | current)
12. L Ipp | 1.993 A | Inductor | Peak-to-peak inductor ripple current
13. L Pd | 312.45 mW | Inductor | Inductor power dissipation
14. Cin Pd | 12.455 mW | Power | Input capacitor power dissipation
15. Cout Pd | 1.005 mW | Power | Output capacitor power dissipation
16. IC Pd | 1.584 W | Power | IC power dissipation
17. L Pd | 312.45 mW | Power | Inductor power dissipation
18. Total Pd | 1.91 W | Power | Total Power Dissipation
19. BOM Count | 11 | System
| | | Information | Total Design BOM count
20. Duty Cycle | 28.705 % | System
| | | Information | Duty cycle
21. Efficiency | 94.015 % | System
| | | Information | Steady state efficiency
22. FootPrint | 153.0 mm² | System
| | | Information | Total Foot Print Area of BOM components
23. Frequency | 558.453 kHz | System
| | | Information | Switching frequency
24. Iout | 6.0 A | System
| | | Information | Iout operating point
25. Mode | CCM | System
| | | Information | Conduction Mode
26. Pout | 30.0 W | System
| | | Information | Total output power
27. Total BOM | $2.66 | System
| | | Information | Total BOM Cost
28. Vin | 18.0 V | System
| | | Information | Vin operating point
29. Vin p-p | 1.466 V | System
| | | Information | Peak-to-peak input voltage
30. Vout | 5.0 V | System
| | | Information | Operational Output Voltage
31. Vout Actual | 4.992 V | System
| | | Information | Vout Actual calculated based on selected voltage divider resistors
32. Vout Tolerance | 3.474 % | System
| | | Information | Vout Tolerance based on IC Tolerance (no load) and voltage divider resistors if applicable
33. Vout p-p | 14.866 mV | System
| | | Information | Peak-to-peak output ripple voltage

## Design Inputs

Name | Value | Description
Iout | 6.0 | Maximum Output Current
VinMax | 18.0 | Maximum input voltage
VinMin | 9.0 | Minimum input voltage
Vout | 5.0 | Output Voltage
| base_pn | | TPS56637 | Base Product Number
source | DC | Input Source Type
Ta | 30.0 | Ambient temperature


Copyright © 2025, Texas Instruments Incorporated | 6 | ti.com/webench

## Assembly

## Component Testing

Some published data on components in datasheets such as Capacitor ESR and Inductor DC resistance is based on conservative values that will guarantee that the components always exceed the specification. For design purposes it is usually better to work with typical values. Since this data is not always available it is a good practice to measure the Capacitance and ESR values of Cin and Cout, and the inductance and DC resistance of L1 before assembly of the board. Any large discrepancies in values should be electrically simulated in WEBENCH to check for instabilities and thermally simulated in WebTHERM to make sure critical temperatures are not exceeded.

## Soldering Component to Board

If board assembly is done in house it is best to tack down one terminal of a component on the board then solder the other terminal. For surface mount parts with large tabs, such as the DPAK, the tab on the back of the package should be pre-tinned with solder, then tacked into place by one of the pins. To solder the tab town to the board place the iron down on the board while resting against the tab, heating both surfaces simultaneously. Apply light pressure to the top of the plastic case until the solder flows around the part and the part is flush with the PCB. If the solder is not flowing around the board you may need a higher wattage iron (generally 25W to 30W is enough).

## Initial Startup of Circuit

It is best to initially power up the board by setting the input supply voltage to the lowest operating input voltage 9.0V and set the input supply's current limit to zero. With the input supply off connect up the input supply to Vin and GND. Connect a digital volt meter and a load if needed to set the minimum Iout of the design from Vout and GND. Turn on the input supply and slowly turn up the current limit on the input supply. If the voltage starts to rise on the input supply continue increasing the input supply current limit while watching the output voltage. If the current increases on the input supply, but the voltage remains near zero, then there may be a short or a component misplaced on the board. Power down the board and visually inspect for solder bridges and recheck the diode and capacitor polarities. Once the power supply circuit is operational then more extensive testing may include full load testing, transient load and line tests to compare with simulation results.

## Load Testing

The setup is the same as the initial startup, except that an additional digital voltmeter is connected between Vin and GND, a load is connected between Vout and GND and a current meter is connected in series between Vout and the load. The load must be able to handle at least rated output power + 50% ( 7.5 watts for this design). Ideally the load is supplied in the form of a variable load test unit. It can also be done in the form of suitably large power resistors. When using an oscilloscope to measure waveforms on the prototype board, the ground leads of the oscilloscope probes should be as short as possible and the area of the loop formed by the ground lead should be kept to a minimum. This will help reduce ground lead inductance and eliminate EMI noise that is not actually present in the circuit.

## Design Assistance

1. Master key : AD9ABD3FB6EB8E71BDFD117B90420B13[v1]
2. TPS56637 Product Folder : http://www.ti.com/product/TPS56637 : contains the data sheet and other resources.

Copyright © 2025, Texas Instruments Incorporated | 7 | ti.com/webench

Important Notice and Disclaimer

TI provides technical and reliability data (including datasheets), design resources (including reference designs), application or other design advice, web tools, safety information, and other resources AS IS and with all faults, and disclaims all warranties. These resources are intended for skilled developers designing with TI products. You are solely responsible for (1) selecting the appropriate TI products for your application, (2) designing, validating and testing your application, and (3) ensuring your application meets applicable standards, and any other safety, security, or other requirements.

These resources are subject to change without notice. TI grants you permission to use these resources only for development of an application that uses the TI products described in the resource. Other reproduction and display of these resources is prohibited. No license is granted to any other TI intellectual property right or to any third party intellectual property right. TI disclaims responsibility for, and you will fully indemnify TI and its representatives against, any claims, damages, costs, losses, and liabilities arising out of your use of these resources.

Providing these resources does not expand or otherwise alter TI's applicable Terms of Sale or other applicable terms available either on ti.com or provided in conjunction with TI products.
