WREC-UofA/WRECtangle/(list of files, drawings)

Other design files:
Designs/KiCAD Files/BreakoutPinBoard/Board1.epro
