WREC-UofA/WRECtangle/Designs/KiCAD Files/WRECtangleVersions/V4.1/Wrectangle-V4/Wrectangle-V4.kicad_sch

## KiCad design Designs/KiCAD Files/WRECtangleVersions/V4.1/Wrectangle-V4/Wrectangle-V4.kicad_sch (2026-02-14)

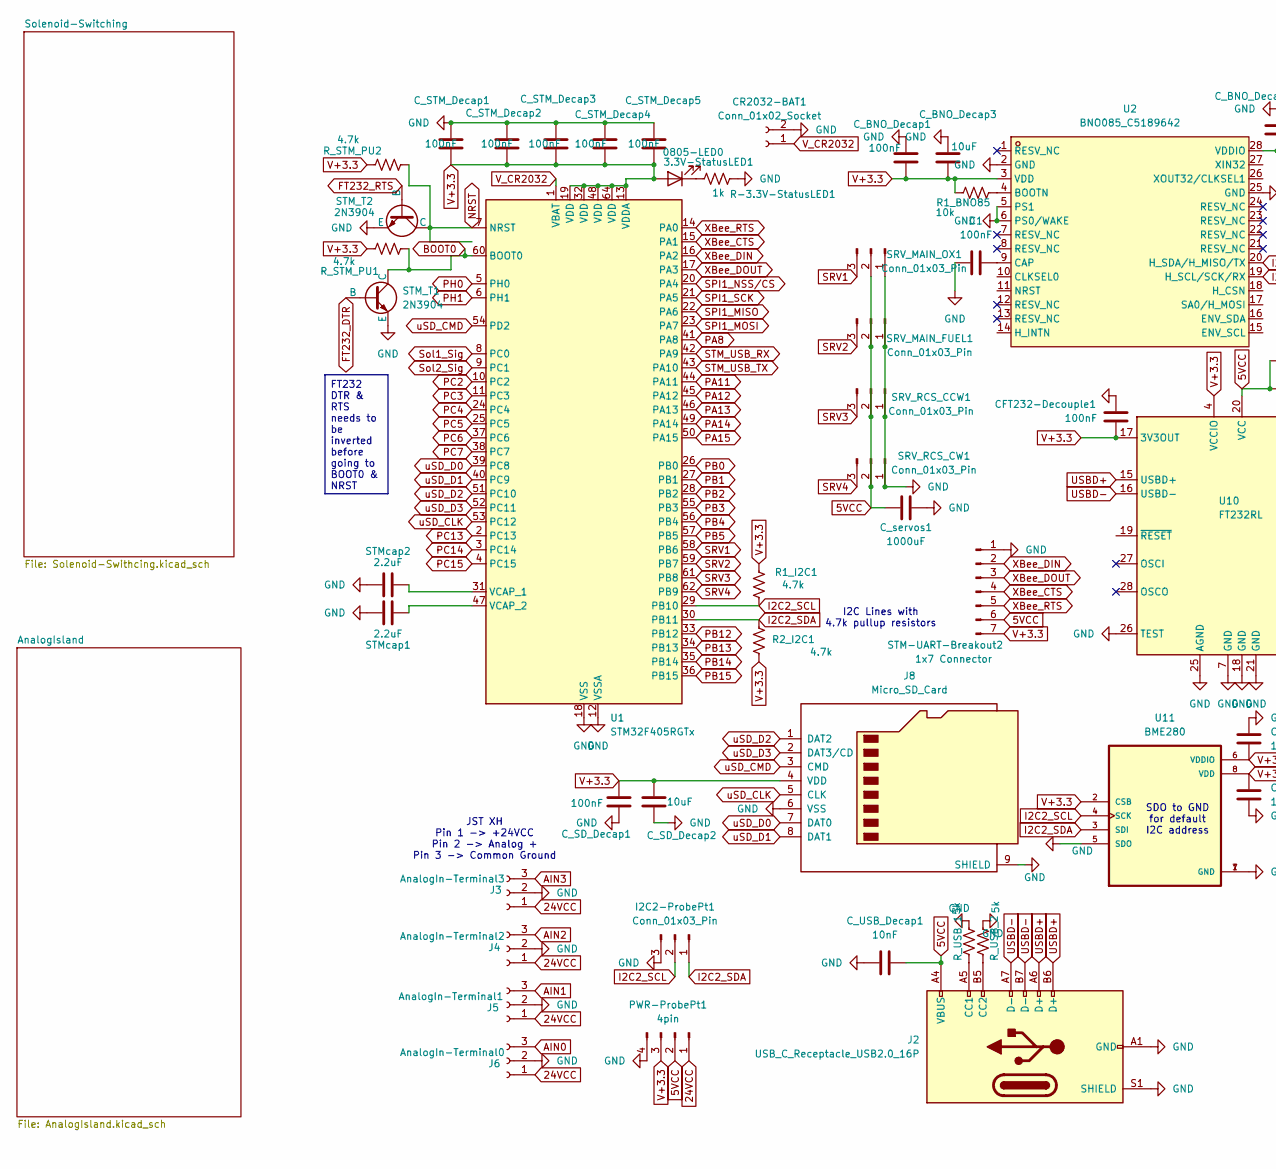
[picture p28: schematic Wrectangle-V4.kicad_sch, part in row 1, column 1]


Parts:
3.3V-StatusLED1: 0805-LED0; LED_0805_2012Metric_Pad1.15x1.40mm_HandSolder
C1: 100nF
C1_BME280, C2_BME280: 100nF; C_0805_2012Metric_Pad1.18x1.45mm_HandSolder
CFT232-Decouple1: 100nF; C_0805_2012Metric_Pad1.18x1.45mm_HandSolder
CR2032-BAT1: Conn_01x02_Socket; BatteryHolder_Keystone_1060_1x2032
C_BNO_Decap1, C_BNO_Decap2: 100nF; C_0603_1608Metric_Pad1.08x0.95mm_HandSolder
C_BNO_Decap3, C_BNO_Decap4: 10uF; C_0603_1608Metric_Pad1.08x0.95mm_HandSolder
C_FTdecouple1: 100nF; C_0805_2012Metric_Pad1.18x1.45mm_HandSolder
C_FTdecouple2: 4.7uF; C_0805_2012Metric_Pad1.18x1.45mm_HandSolder
C_GPS_Decap1: 10uF; C_0603_1608Metric_Pad1.08x0.95mm_HandSolder
C_GPS_Decap2: 100nF; C_0603_1608Metric_Pad1.08x0.95mm_HandSolder
C_H3L_Decap1: 10uF; C_0603_1608Metric_Pad1.08x0.95mm_HandSolder
C_H3L_Decap2: 100nF; C_0603_1608Metric_Pad1.08x0.95mm_HandSolder
C_SD_Decap1: 100nF; C_0603_1608Metric_Pad1.08x0.95mm_HandSolder
C_SD_Decap2: 10uF; C_0603_1608Metric_Pad1.08x0.95mm_HandSolder
C_STM_Decap1, C_STM_Decap2, C_STM_Decap3, C_STM_Decap4, C_STM_Decap5: 100nF; C_0603_1608Metric_Pad1.08x0.95mm_HandSolder
C_USB_Decap1: 10nF; C_0805_2012Metric_Pad1.18x1.45mm_HandSolder
C_XBee-Decap1: 10uF; C_0603_1608Metric_Pad1.08x0.95mm_HandSolder
C_XBee_Decap2: 100nF; C_0603_1608Metric_Pad1.08x0.95mm_HandSolder
C_servos1: 1000uF; CP_Radial_D10.0mm_P5.00mm
I2C2-ProbePt1: Conn_01x03_Pin; PinHeader_1x03_P2.54mm_Vertical
J2: USB_C_Receptacle_USB2.0_16P; USB_C_Receptacle_Amphenol_124019772112A
J3: AnalogIn-Terminal3; JST_XH_B3B-XH-AM_1x03_P2.50mm_Vertical
J4: AnalogIn-Terminal2; JST_XH_B3B-XH-AM_1x03_P2.50mm_Vertical
J5: AnalogIn-Terminal1; JST_XH_B3B-XH-AM_1x03_P2.50mm_Vertical
J6: AnalogIn-Terminal0; JST_XH_B3B-XH-AM_1x03_P2.50mm_Vertical
J7: GPS-Antenna; SMA_Amphenol_901-144_Vertical; PARTREV C4
J8: Micro_SD_Card; microSD_HC_Wuerth_693072010801
J10: xBee-Antenna1; SMA_Amphenol_901-144_Vertical
PWR-ProbePt1: 4pin; PinHeader_1x04_P2.54mm_Vertical
R1_BNO85: 10k; R_Axial_DIN0204_L3.6mm_D1.6mm_P2.54mm_Vertical
R1_I2C1, R2_I2C1: 4.7k; C_0603_1608Metric_Pad1.08x0.95mm_HandSolder
R-3.3V-StatusLED1: 1k; LED_0805_2012Metric_Pad1.15x1.40mm_HandSolder
R_STM_PU1, R_STM_PU2: 4.7k; C_0603_1608Metric_Pad1.08x0.95mm_HandSolder
R_USB_1, R_USB_2: 5k; R_1206_3216Metric_Pad1.30x1.75mm_HandSolder
R_USB_rx_LED1: 1k; R_0805_2012Metric_Pad1.20x1.40mm_HandSolder
R_USB_tx_LED1: 1k; R_0805_2012Metric_Pad1.20x1.40mm_HandSolder
SPI-ProbePt1: 6pin; PinHeader_1x06_P2.54mm_Vertical
SRV_MAIN_FUEL1: Conn_01x03_Pin; PinHeader_1x03_P2.54mm_Vertical
SRV_MAIN_OX1: Conn_01x03_Pin; PinHeader_1x03_P2.54mm_Vertical
SRV_RCS_CCW1: Conn_01x03_Pin; PinHeader_1x03_P2.54mm_Vertical
SRV_RCS_CW1: Conn_01x03_Pin; PinHeader_1x03_P2.54mm_Vertical
STM-UART-Breakout1, STM-UART-Breakout2: 1x7 Connector; PinHeader_1x05_P2.54mm_Vertical
STM_T1, STM_T2: 2N3904; TO-92L
STMcap1, STMcap2: 2.2uF; C_0603_1608Metric_Pad1.08x0.95mm_HandSolder
U1: STM32F405RGTx; LQFP-64_10x10mm_P0.5mm
U2: BNO085_C5189642; IC_BNO085; LCSC Part C5189642
U3: MAX-M10S-00B; XCVR_MAX-M10S-00B; LCSC Part C4153167
U4: H3LIS331DLTR; QFN300X300X100-16N; LCSC Part C2655074
U9: XBP9X-DMUS-001; XCVR_XBP9X-DMUS-001; PARTREV K
U10: FT232RL; SSOP-28_5.3x10.2mm_P0.65mm
U11: BME280; PSON65P250X250X100-8N
USB_rx_LED1: 0805-LED2; LED_0805_2012Metric_Pad1.15x1.40mm_HandSolder
USB_tx_LED1: 0805-LED1; LED_0805_2012Metric_Pad1.15x1.40mm_HandSolder

Connections:
5VCC: C_FTdecouple1.1, C_FTdecouple2.1, C_USB_Decap1.2, C_servos1.1, J2.A4 (VBUS), J2.A9 (VBUS), J2.B4 (VBUS), J2.B9 (VBUS), PWR-ProbePt1.2, SRV_MAIN_FUEL1.2, SRV_MAIN_OX1.2, SRV_RCS_CCW1.2, SRV_RCS_CW1.2, STM-UART-Breakout1.1, STM-UART-Breakout2.6, U10.20 (VCC)
24VCC: J3.1, J4.1, J5.1, J6.1, PWR-ProbePt1.1
AIN0: J6.3
AIN1: J5.3
AIN2: J4.3
AIN3: J3.3
BOOT0: R_STM_PU1.2, STM-UART-Breakout1.5, STM_T1.3 (C), U1.60 (BOOT0)
FT232_DTR: STM_T1.2 (B), U10.2 (DTR)
FT232_RTS: STM_T2.2 (B), U10.3 (RTS)
GND: C1.1, C1_BME280.1, C2_BME280.2, CFT232-Decouple1.1, CR2032-BAT1.2, C_BNO_Decap1.1, C_BNO_Decap2.1, C_BNO_Decap3.1, C_BNO_Decap4.1, C_FTdecouple1.2, C_FTdecouple2.2, C_GPS_Decap1.1, C_GPS_Decap2.1, C_H3L_Decap1.1, C_H3L_Decap2.1, C_SD_Decap1.1, C_SD_Decap2.1, C_STM_Decap1.1, C_STM_Decap2.1, C_STM_Decap3.1, C_STM_Decap4.1, C_STM_Decap5.1, C_USB_Decap1.1, C_XBee-Decap1.1, C_XBee_Decap2.1, C_servos1.2, I2C2-ProbePt1.3, J2.A1 (GND), J2.A12 (GND), J2.B1 (GND), J2.B12 (GND), J2.S1 (SHIELD), J3.2, J4.2, J5.2, J6.2, J7.2 (Ext), J8.6 (VSS), J8.9 (SHIELD), J10.2 (Ext), PWR-ProbePt1.4, R-3.3V-StatusLED1.1, R_USB_1.1, R_USB_2.1, SPI-ProbePt1.6, SRV_MAIN_FUEL1.1, SRV_MAIN_OX1.1, SRV_RCS_CCW1.1, SRV_RCS_CW1.1, STM-UART-Breakout1.7, STM-UART-Breakout2.1, STM_T1.1 (E), STM_T2.1 (E), STMcap1.1, STMcap2.1, U1.12 (VSSA), U1.18 (VSS), U1.63 (VSS), U2.2 (GND), U2.5 (PS1), U2.6 (PS0/WAKE), U2.25 (GND), U3.1 (GND), U3.10 (GND), U3.12 (GND), U4.5 (GND), U4.12 (GND), U4.13 (GND), U4.16 (GND), U9.1 (GND), U9.11 (GND), U9.13 (GND), U9.22 (GND), U9.35 (GND), U9.38 (GND), U10.7 (GND), U10.18 (GND), U10.21 (GND), U10.25 (AGND), U10.26 (TEST), U11.1 (GND), U11.5 (SDO), U11.7 (GND)
I2C2_SCL: I2C2-ProbePt1.2, R1_I2C1.2, U1.29 (PB10), U2.19 (H_SCL/SCK/RX), U3.17 (SCL), U4.4 (SCL/SPS), U11.4 (SCK)
I2C2_SDA: I2C2-ProbePt1.1, R2_I2C1.1, U1.30 (PB11), U2.20 (H_SDA/H_MISO/TX), U3.16 (SDA), U4.6 (SDA/SDI/SDO), U11.3 (SDI)
NRST: R_STM_PU2.2, STM-UART-Breakout1.6, STM_T2.3 (C), U1.7 (NRST)
unnamed: 3.3V-StatusLED1.1 (K), R-3.3V-StatusLED1.2
unnamed: C1.2, U2.9 (CAP)
unnamed: J2.A5 (CC1), R_USB_1.2
unnamed: J2.B5 (CC2), R_USB_2.2
unnamed: J7.1 (In), U3.11 (RF_IN)
unnamed: J10.1 (In), U9.36 (RF_PAD)
unnamed: R1_BNO85.1, U2.4 (BOOTN)
unnamed: R_USB_rx_LED1.1, U10.22 (CBUS1)
unnamed: R_USB_rx_LED1.2, USB_rx_LED1.1 (K)
unnamed: R_USB_tx_LED1.1, U10.23 (CBUS0)
unnamed: R_USB_tx_LED1.2, USB_tx_LED1.1 (K)
unnamed: STMcap1.2, U1.47 (VCAP_2)
unnamed: STMcap2.2, U1.31 (VCAP_1)
PA8: U1.41 (PA8)
PA11: U1.44 (PA11)
PA12: U1.45 (PA12)
PA13: U1.46 (PA13)
PA14: U1.49 (PA14)
PA15: U1.50 (PA15)
PB0: U1.26 (PB0)
PB1: U1.27 (PB1)
PB2: U1.28 (PB2)
PB3: U1.55 (PB3)
PB4: U1.56 (PB4)
PB5: U1.57 (PB5)
PB12: U1.33 (PB12)
PB13: U1.34 (PB13)
PB14: U1.35 (PB14)
PB15: U1.36 (PB15)
PC2: U1.10 (PC2)
PC3: U1.11 (PC3)
PC4: U1.24 (PC4)
PC5: U1.25 (PC5)
PC6: U1.37 (PC6)
PC7: U1.38 (PC7)
PC13: U1.2 (PC13)
PC14: U1.3 (PC14)
PC15: U1.4 (PC15)
PH0: U1.5 (PH0)
PH1: U1.6 (PH1)
SPI1_MISO: SPI-ProbePt1.4, U1.22 (PA6)
SPI1_MOSI: SPI-ProbePt1.5, U1.23 (PA7)
SPI1_NSS/CS: SPI-ProbePt1.2, U1.20 (PA4)
SPI1_SCK: SPI-ProbePt1.3, U1.21 (PA5)
SRV1: SRV_MAIN_OX1.3, U1.58 (PB6)
SRV2: SRV_MAIN_FUEL1.3, U1.59 (PB7)
SRV3: SRV_RCS_CCW1.3, U1.61 (PB8)
SRV4: SRV_RCS_CW1.3, U1.62 (PB9)
STM_USB_RX: STM-UART-Breakout1.3, U1.42 (PA9), U10.5 (RXD)
STM_USB_TX: STM-UART-Breakout1.4, U1.43 (PA10), U10.1 (TXD)
Sol1_Sig: U1.8 (PC0)
Sol2_Sig: U1.9 (PC1)
USBD+: J2.A6 (D+), J2.B6 (D+), U10.15 (USBD+)
USBD-: J2.A7 (D-), J2.B7 (D-), U10.16 (USBD-)
V+3.3: 3.3V-StatusLED1.2 (A), C1_BME280.2, C2_BME280.1, CFT232-Decouple1.2, C_BNO_Decap1.2, C_BNO_Decap2.2, C_BNO_Decap3.2, C_BNO_Decap4.2, C_GPS_Decap1.2, C_GPS_Decap2.2, C_H3L_Decap1.2, C_H3L_Decap2.2, C_SD_Decap1.2, C_SD_Decap2.2, C_STM_Decap1.2, C_STM_Decap2.2, C_STM_Decap3.2, C_STM_Decap4.2, C_STM_Decap5.2, C_XBee-Decap1.2, C_XBee_Decap2.2, J8.4 (VDD), PWR-ProbePt1.3, R1_BNO85.2, R1_I2C1.1, R2_I2C1.2, R_STM_PU1.1, R_STM_PU2.1, SPI-ProbePt1.1, STM-UART-Breakout1.2, STM-UART-Breakout2.7, U1.13 (VDDA), U1.19 (VDD), U1.32 (VDD), U1.48 (VDD), U1.64 (VDD), U2.3 (VDD), U2.28 (VDDIO), U3.7 (V_IO), U3.8 (VCC), U4.1 (Vdd_IO), U4.14 (Vdd), U9.2 (VCC), U10.4 (VCCIO), U10.17 (3V3OUT), U11.2 (CSB), U11.6 (VDDIO), U11.8 (VDD), USB_rx_LED1.2 (A), USB_tx_LED1.2 (A)
V_CR2032: CR2032-BAT1.1, U1.1 (VBAT)
XBee_CTS: STM-UART-Breakout2.4, U1.15 (PA1), U9.25 (DIO7/~CTS)
XBee_DIN: STM-UART-Breakout2.2, U1.16 (PA2), U9.4 (DIO14/DIN/~CONFIG)
XBee_DOUT: STM-UART-Breakout2.3, U1.17 (PA3), U9.3 (DIO13/DOUT)
XBee_RTS: STM-UART-Breakout2.5, U1.14 (PA0), U9.29 (DIO6/~RTS)
uSD_CLK: J8.5 (CLK), U1.53 (PC12)
uSD_CMD: J8.3 (CMD), U1.54 (PD2)
uSD_D0: J8.7 (DAT0), U1.39 (PC8)
uSD_D1: J8.8 (DAT1), U1.40 (PC9)
uSD_D2: J8.1 (DAT2), U1.51 (PC10)
uSD_D3: J8.2 (DAT3/CD), U1.52 (PC11)

Notes on the sheet:
I2C Lines with 4.7k pullup resistors
JST XH Pin 1 -> +24VCC Pin 2 -> Analog + Pin 3 -> Common Ground
SDO to GND for default I2C address
FT232 DTR & RTS needs to be inverted before going to BOOT0 & NRST
