WREC-UofA/WRECtangle/(commit log)

2026-02-07 Add solenoid and communication tests
2026-02-07 Breakout Board
    one of many uploads.
    [Board1-Bottom Layer.gbr, Board1-Bottom Paste Mask Layer.gbr, Board1-Bottom Silkscreen Layer.gbr, Board1-Bottom Solder Mask Layer.gbr, Board1-Edge Cuts.gbr, Board1-Edge Cuts.gko, Board1-Edge_Cuts.gbr, Board1-F_Cu.gbr]
2026-02-07 upload a bunch of stuff
    [12V-5V-PowerCircuit.kicad_sch, 12V-PowerCircuit.kicad_sch, 24V-PowerCircuit.kicad_sch, 5V-PowerCircuit.kicad_sch, AnalogIsland.kicad_sch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]
2026-02-13 made folder for schematic of nucleo dev board converted to kicad files
2026-02-13 making new version of board
    [Board1-Bottom Layer.gbr, Board1-Bottom Paste Mask Layer.gbr, Board1-Bottom Silkscreen Layer.gbr, Board1-Bottom Solder Mask Layer.gbr, Board1-Edge Cuts.gbr, Board1-Edge Cuts.gko, Board1-Edge_Cuts.gbr, Board1-F_Cu.gbr]
2026-02-14 test etan
    [Wrectangle-V4.kicad_sch]
2026-02-14 idk nothing pry
    [Wrectangle-V4.kicad_sch]
